nyarurato/RRFExtRP2040Board/docs/v0.2/RRFExtRP2040_v_0_2.pdf

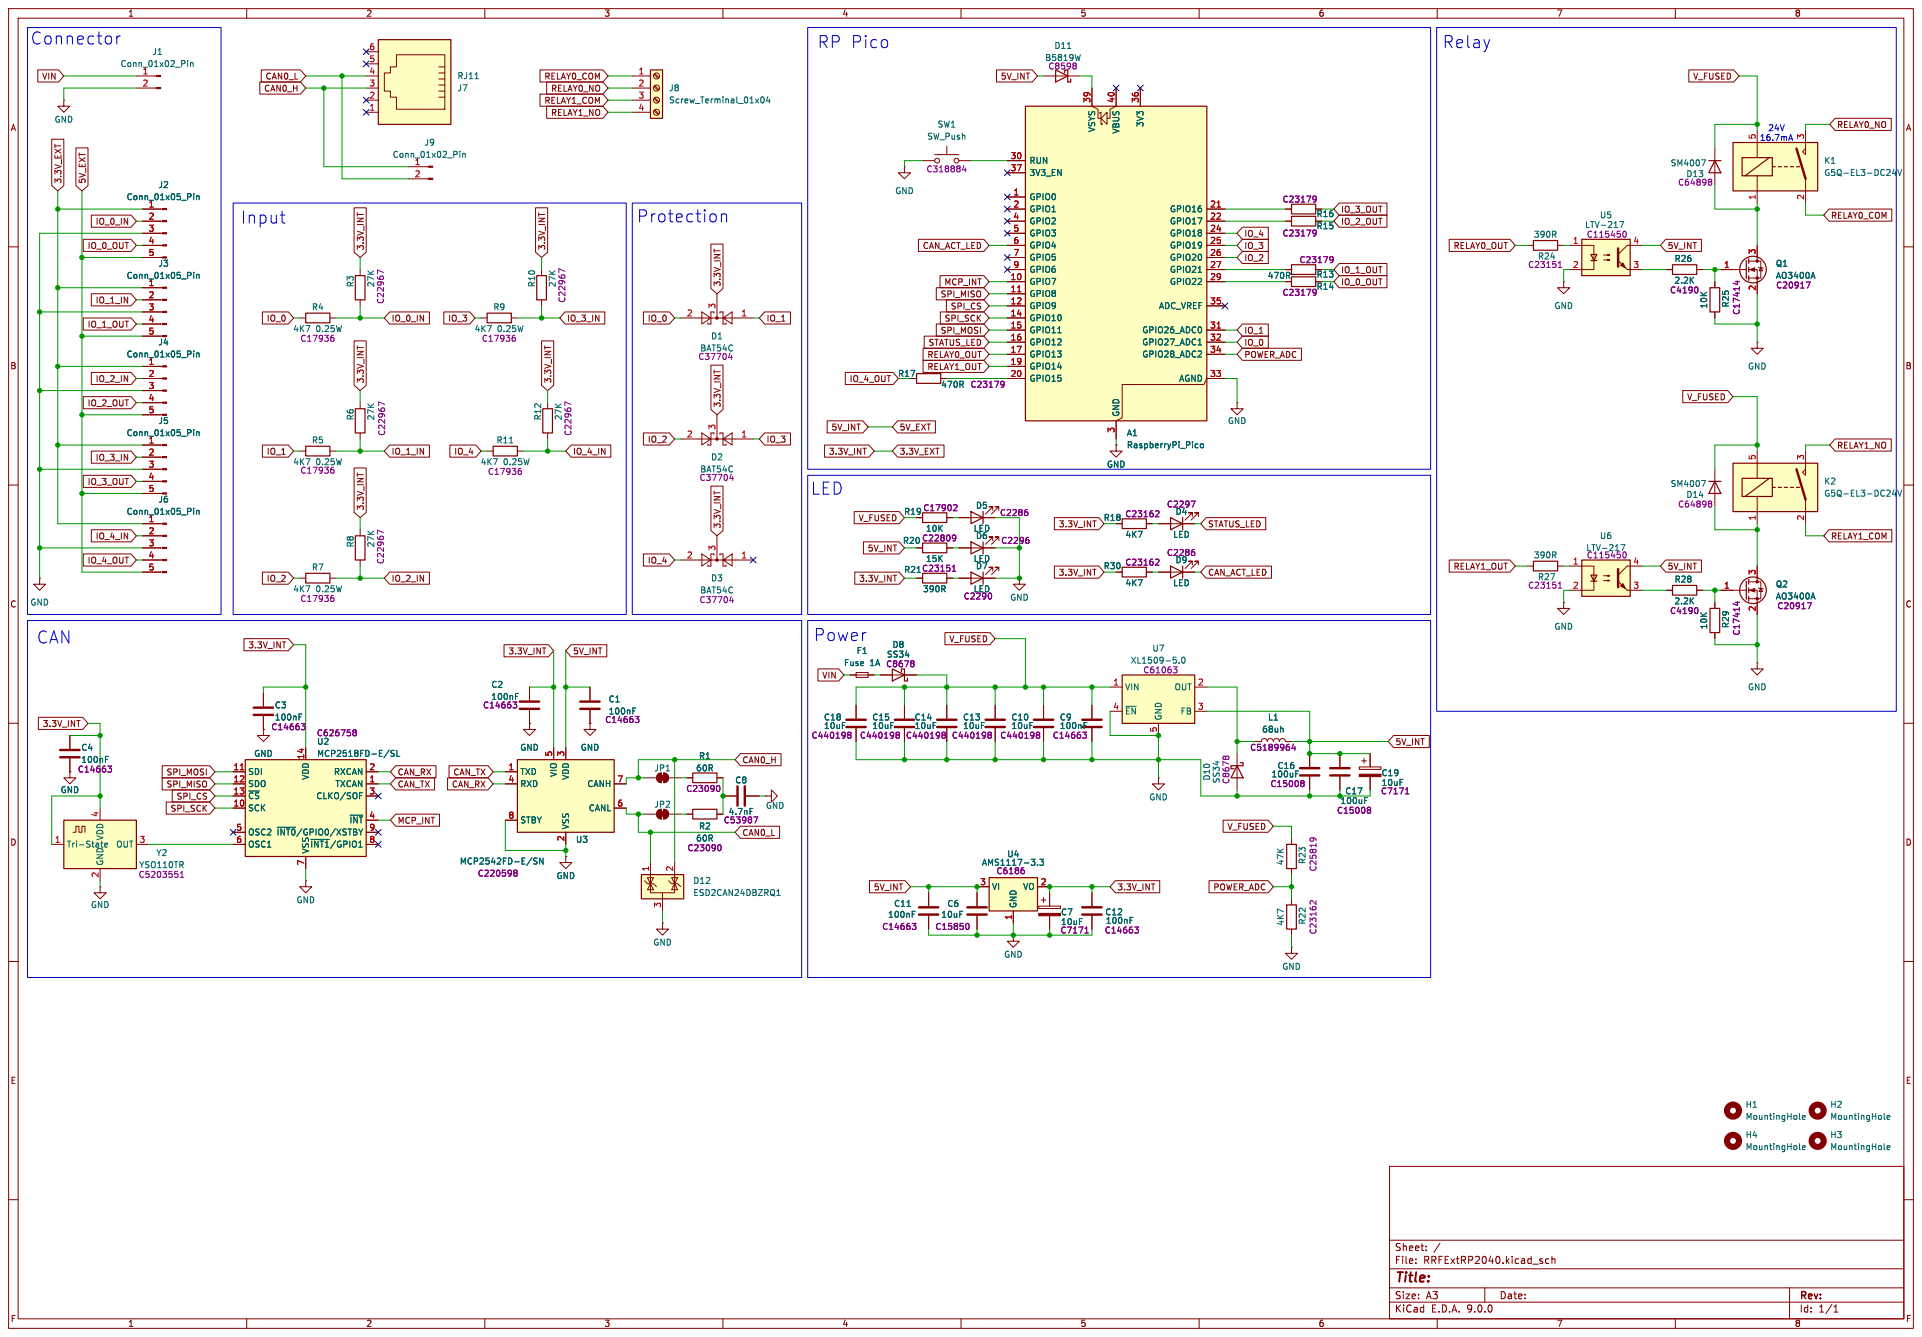
[picture p5: page 1]

7 RXCAN 2 TXCAN 1 CLKO/SOF 3 ~{INT}4 ~{INT0}/GPIO0/XSTBY 9 ~{INT1}/GPIO1 8 U2 MCP2518FD-E/SL C626758 GND

7 RXCAN 2 TXCAN 1 CLKO/SOF 3 ~{INT}4 ~{INT0}/GPIO0/XSTBY 9 ~{INT1}/GPIO1 8 GND
