nyarurato/RRFExtRP2040Board/RRFExtRP2040.kicad_pcb

## KiCad design RRFExtRP2040.kicad_pcb (2026-07-21)

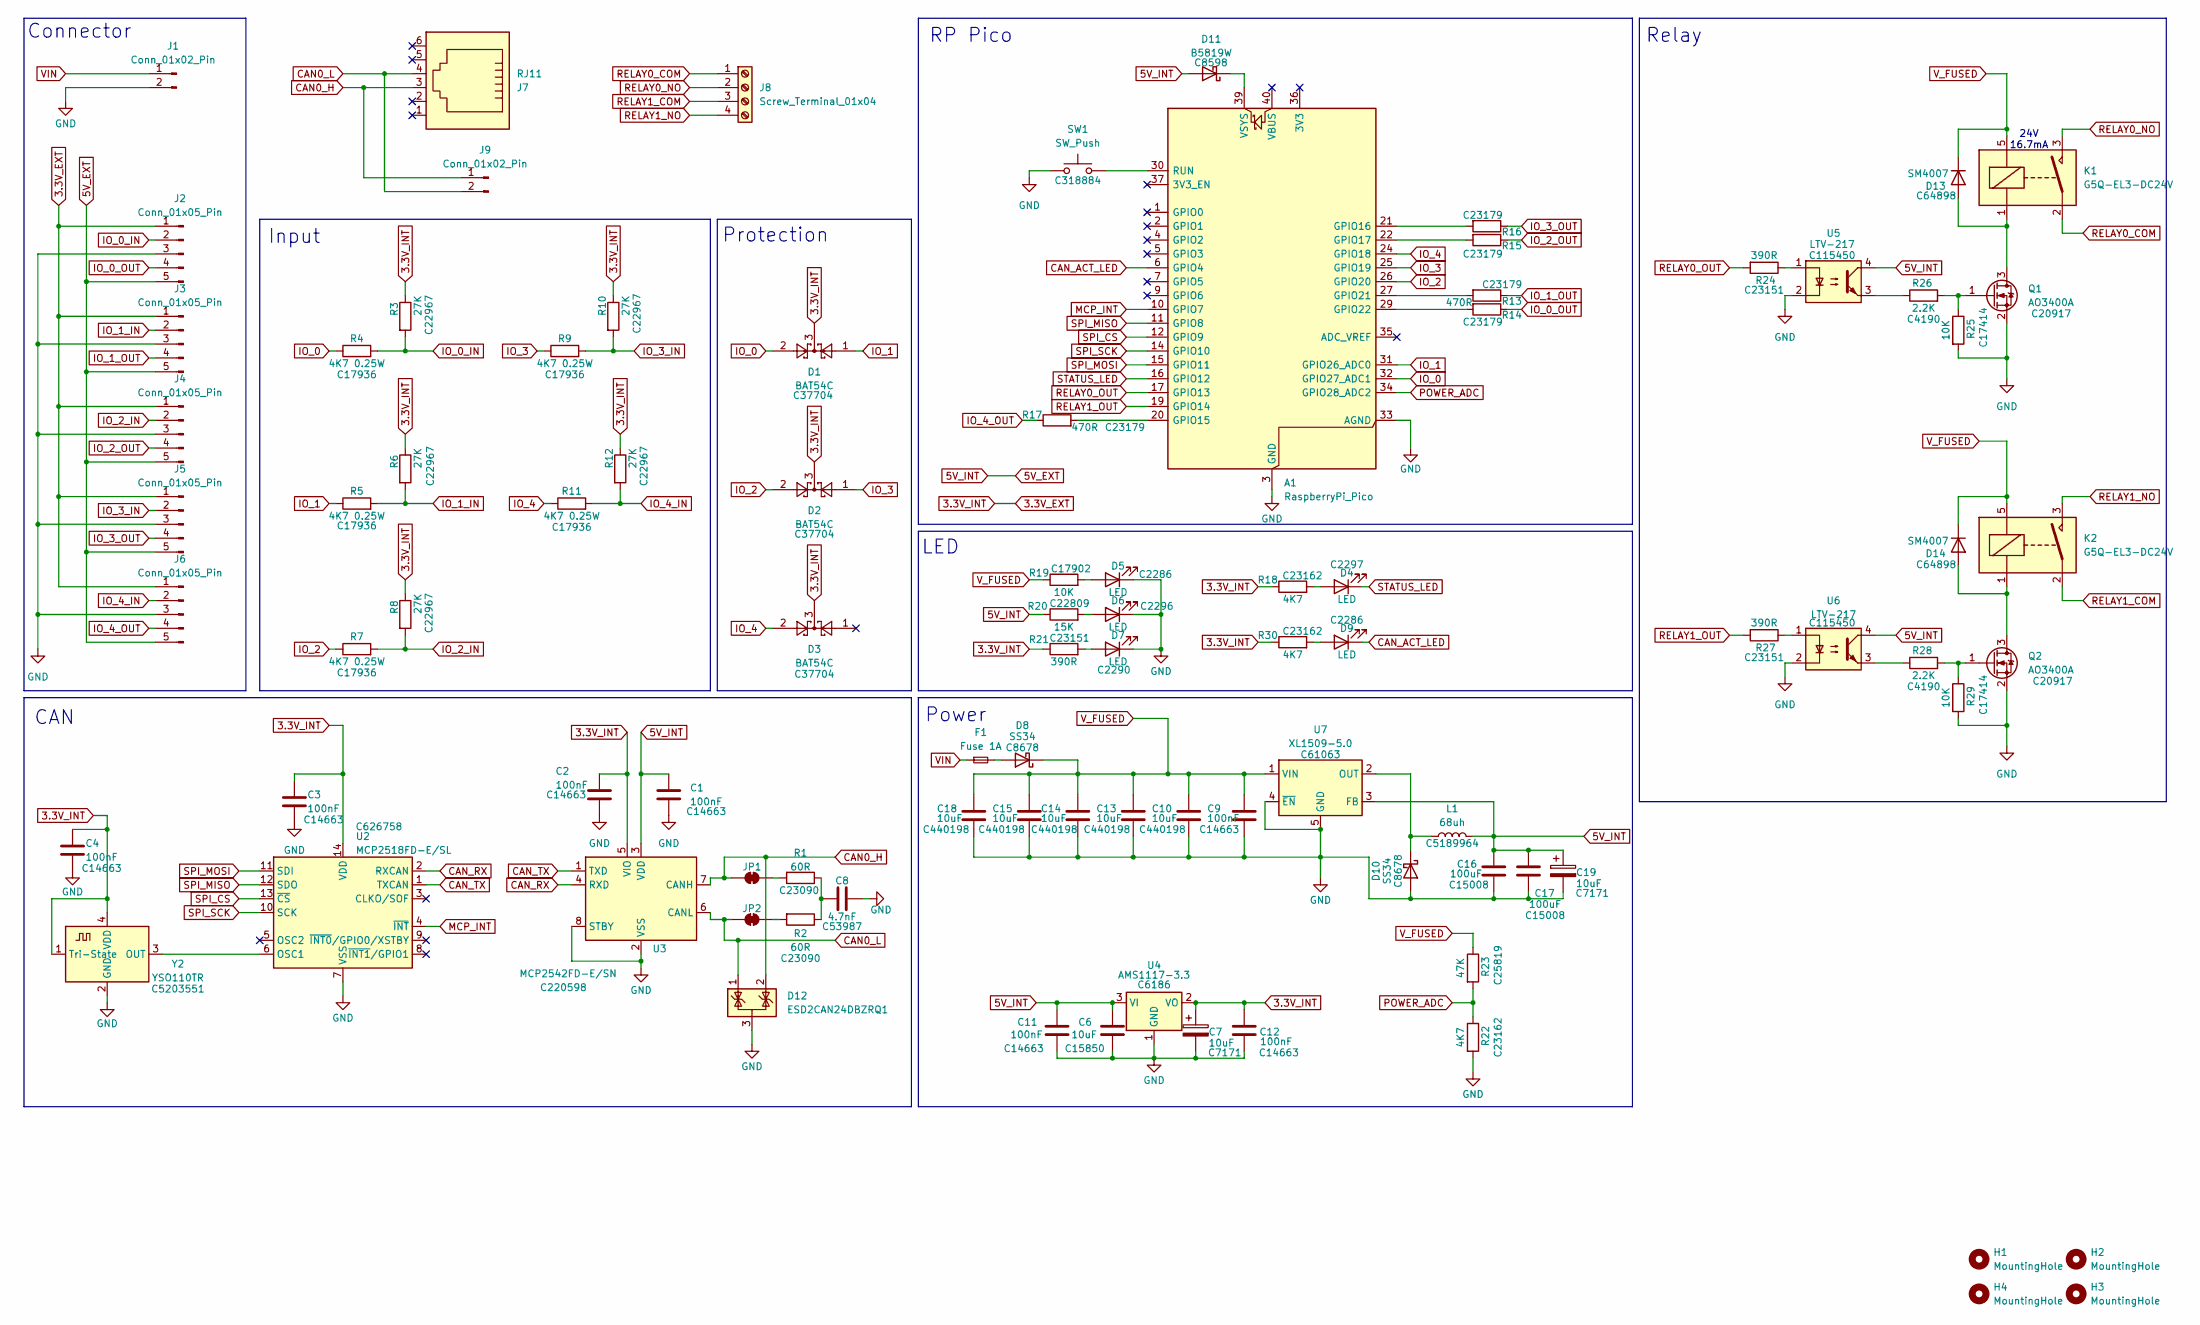
[picture p6: schematic RRFExtRP2040.kicad_sch]

Parts:
A1: RaspberryPi_Pico; RaspberryPi_Pico_Common_Unspecified
C1, C2, C3, C4, C9, C11, C12: 100nF; C_0603_1608Metric; LCSC PN C14663
C6: 10uF; C_0805_2012Metric; LCSC PN C15850
C7, C19: 10uF; CP_EIA-3216-18_Kemet-A; LCSC PN C7171
C8: 4.7nF; C_0603_1608Metric; LCSC PN C53987
C10, C13, C14, C15, C18: 10uF; C_0805_2012Metric; LCSC PN C440198
C16, C17: 100uF; C_1206_3216Metric; LCSC PN C15008
D1, D2, D3: BAT54C; SOT-23; LCSC PN C37704
D4: LED; LED_0805_2012Metric; LCSC PN C2297
D5, D9: LED; LED_0603_1608Metric; LCSC PN C2286
D6: LED; LED_0805_2012Metric; LCSC PN C2296
D7: LED; LED_0603_1608Metric; LCSC PN C2290
D8, D10: SS34; D_SMA; LCSC PN C8678
D11: B5819W; D_SOD-123; LCSC PN C8598
D12: ESD2CAN24DBZRQ1; SOT-23-3
D13, D14: SM4007; D_SOD-123F; LCSC PN C64898
F1: Fuse 1A; Fuse_1206_3216Metric
H1, H2, H3, H4: MountingHole; MountingHole_3.2mm_M3
J1: Conn_01x02_Pin; JST_VH_B2P-VH-B_1x02_P3.96mm_Vertical
J2, J3, J4, J5, J6: Conn_01x05_Pin; Molex_KK-254_AE-6410-05A_1x05_P2.54mm_Vertical
J7: RJ11; 615006138421
J8: Screw_Terminal_01x04; HB9500-9.5-4P
J9: Conn_01x02_Pin; Molex_KK-254_AE-6410-02A_1x02_P2.54mm_Vertical
JP1, JP2: SolderJumper_2_Bridged; SolderJumper-2_P1.3mm_Bridged_Pad1.0x1.5mm
K1, K2: G5Q-EL3-DC24V; Relay_SPST_Omron-G5Q-1A
L1: 68uh; IND-SMD_L7.2-W6.6_GPSR07X0; LCSC PN C5189964
Q1, Q2: AO3400A; SOT-23; LCSC PN C20917
R1, R2: 60R; R_0603_1608Metric; LCSC PN C23090
R3, R6, R8, R10, R12: 27K; R_0603_1608Metric; LCSC PN C22967
R4, R5, R7, R9, R11: 4K7 0.25W; R_1206_3216Metric; LCSC PN C17936
R13, R14, R15, R16, R17: 470R; R_0603_1608Metric; LCSC PN C23179
R18, R22, R30: 4K7; R_0603_1608Metric; LCSC PN C23162
R19: 10K; R_1206_3216Metric; LCSC PN C17902
R20: 15K; R_0603_1608Metric; LCSC PN C22809
R21, R24, R27: 390R; R_0603_1608Metric; LCSC PN C23151
R23: 47K; R_0603_1608Metric; LCSC PN C25819
R25, R29: 10K; R_0805_2012Metric; LCSC PN C17414
R26, R28: 2.2K; R_0603_1608Metric; LCSC PN C4190
SW1: SW_Push; SW_Push_1P1T_XKB_TS-1187A; LCSC PN C318884
U2: MCP2518FD-E/SL; SOIC-14_3.9x8.7mm_P1.27mm; LCSC PN C626758
U3: MCP2542FD-E/SN; SOIC-8_3.9x4.9mm_P1.27mm; LCSC PN C220598
U4: AMS1117-3.3; SOT-223-3_TabPin2; LCSC PN C6186
U5, U6: LTV-217; LTV217; LCSC PN C115450
U7: XL1509-5.0; SOIC-8_3.9x4.9mm_P1.27mm; LCSC PN C61063
Y2: YSO110TR; Crystal_SMD_3225-4Pin_3.2x2.5mm; LCSC PN C5203551

Connections:
3.3V_EXT: C2.1, C3.1, C4.1, C7.1, C12.2, D1.3, D2.3, D3.3, J2.1, J3.1, J4.1, J5.1, J6.1, R3.1, R6.1, R8.1, R10.1, R12.1, R18.1, R21.1, R30.1, U2.14 (VDD), U3.5 (VIO), U4.2 (VO), Y2.1 (Tri-State), Y2.4 (VDD)
5V_EXT: C1.1, C6.1, C11.1, C16.1, C17.1, C19.1, D11.2 (A), J2.5, J3.5, J4.5, J5.5, J6.5, L1.2, R20.1, U3.3 (VDD), U4.3 (VI), U5.4, U6.4, U7.3 (FB)
CAN0_H: D12.2 (K), J7.3, J9.1, JP1.1 (A), U3.7 (CANH)
CAN0_L: D12.1 (K), J7.4, J9.2, JP2.1 (A), U3.6 (CANL)
CAN_ACT_LED: A1.6 (GPIO4), D9.1 (K)
CAN_RX: U2.2 (RXCAN), U3.4 (RXD)
CAN_TX: U2.1 (TXCAN), U3.1 (TXD)
GND: A1.3 (GND), A1.8 (GND), A1.13 (GND), A1.18 (GND), A1.23 (GND), A1.28 (GND), A1.33 (AGND), A1.38 (GND), C1.2, C2.2, C3.2, C4.2, C6.2, C7.2, C8.2, C9.2, C10.2, C11.2, C12.1, C13.2, C14.2, C15.2, C16.2, C17.2, C18.2, C19.2, D5.1 (K), D6.1 (K), D7.1 (K), D10.2 (A), D12.3 (A), J1.2, J2.3, J3.3, J4.3, J5.3, J6.3, Q1.2 (S), Q2.2 (S), R22.2, R25.2, R29.2, SW1.1, U2.7 (VSS), U3.2 (VSS), U3.8 (STBY), U3.9 (VSS), U4.1 (GND), U5.2, U6.2, U7.4 (~EN), U7.5 (GND), U7.6 (GND), U7.7 (GND), U7.8 (GND), Y2.2 (GND)
IO_0: A1.32 (GPIO27_ADC1), D1.2, R4.1
IO_0_IN: J2.2, R3.2, R4.2
IO_0_OUT: J2.4, R14.1
IO_1: A1.31 (GPIO26_ADC0), D1.1, R5.1
IO_1_IN: J3.2, R5.2, R6.2
IO_1_OUT: J3.4, R13.1
IO_2: A1.26 (GPIO20), D2.2, R7.1
IO_2_IN: J4.2, R7.2, R8.2
IO_2_OUT: J4.4, R15.1
IO_3: A1.25 (GPIO19), D2.1, R9.1
IO_3_IN: J5.2, R9.2, R10.2
IO_3_OUT: J5.4, R16.1
IO_4: A1.24 (GPIO18), D3.2, R11.1
IO_4_IN: J6.2, R11.2, R12.2
IO_4_OUT: J6.4, R17.1
MCP_INT: A1.10 (GPIO7), U2.4 (~INT)
unnamed: A1.20 (GPIO15), R17.2
unnamed: A1.21 (GPIO16), R16.2
unnamed: A1.22 (GPIO17), R15.2
unnamed: A1.27 (GPIO21), R13.2
unnamed: A1.29 (GPIO22), R14.2
unnamed: A1.30 (RUN), SW1.2
unnamed: A1.39 (VSYS), D11.1 (K)
unnamed: C8.1, R1.1, R2.1
unnamed: D4.2 (A), R18.2
unnamed: D5.2 (A), R19.2
unnamed: D6.2 (A), R20.2
unnamed: D7.2 (A), R21.2
unnamed: D8.2 (A), F1.2
unnamed: D9.2 (A), R30.2
unnamed: D10.1 (K), L1.1, U7.2 (OUT)
unnamed: D13.2 (A), K1.1, Q1.3 (D)
unnamed: D14.2 (A), K2.1, Q2.3 (D)
unnamed: JP1.2 (B), R1.2
unnamed: JP2.2 (B), R2.2
unnamed: Q1.1 (G), R25.1, R26.2
unnamed: Q2.1 (G), R28.2, R29.1
unnamed: R24.1, U5.1
unnamed: R26.1, U5.3
unnamed: R27.1, U6.1
unnamed: R28.1, U6.3
unnamed: U2.6 (OSC1), Y2.3 (OUT)
POWER_ADC: A1.34 (GPIO28_ADC2), R22.1, R23.2
RELAY0_COM: J8.1, K1.2
RELAY0_NO: J8.2, K1.3
RELAY0_OUT: A1.17 (GPIO13), R24.2
RELAY1_COM: J8.3, K2.2
RELAY1_NO: J8.4, K2.3
RELAY1_OUT: A1.19 (GPIO14), R27.2
SPI_CS: A1.12 (GPIO9), U2.13 (~CS)
SPI_MISO: A1.11 (GPIO8), U2.12 (SDO)
SPI_MOSI: A1.15 (GPIO11), U2.11 (SDI)
SPI_SCK: A1.14 (GPIO10), U2.10 (SCK)
STATUS_LED: A1.16 (GPIO12), D4.1 (K)
VIN: F1.1, J1.1
V_FUSED: C9.1, C10.1, C13.1, C14.1, C15.1, C18.1, D8.1 (K), D13.1 (K), D14.1 (K), K1.5, K2.5, R19.1, R23.1, U7.1 (VIN)

Notes on the sheet:
CAN
RP Pico
24V 16.7mA
Connector
Protection
Relay
LED
Power
Input

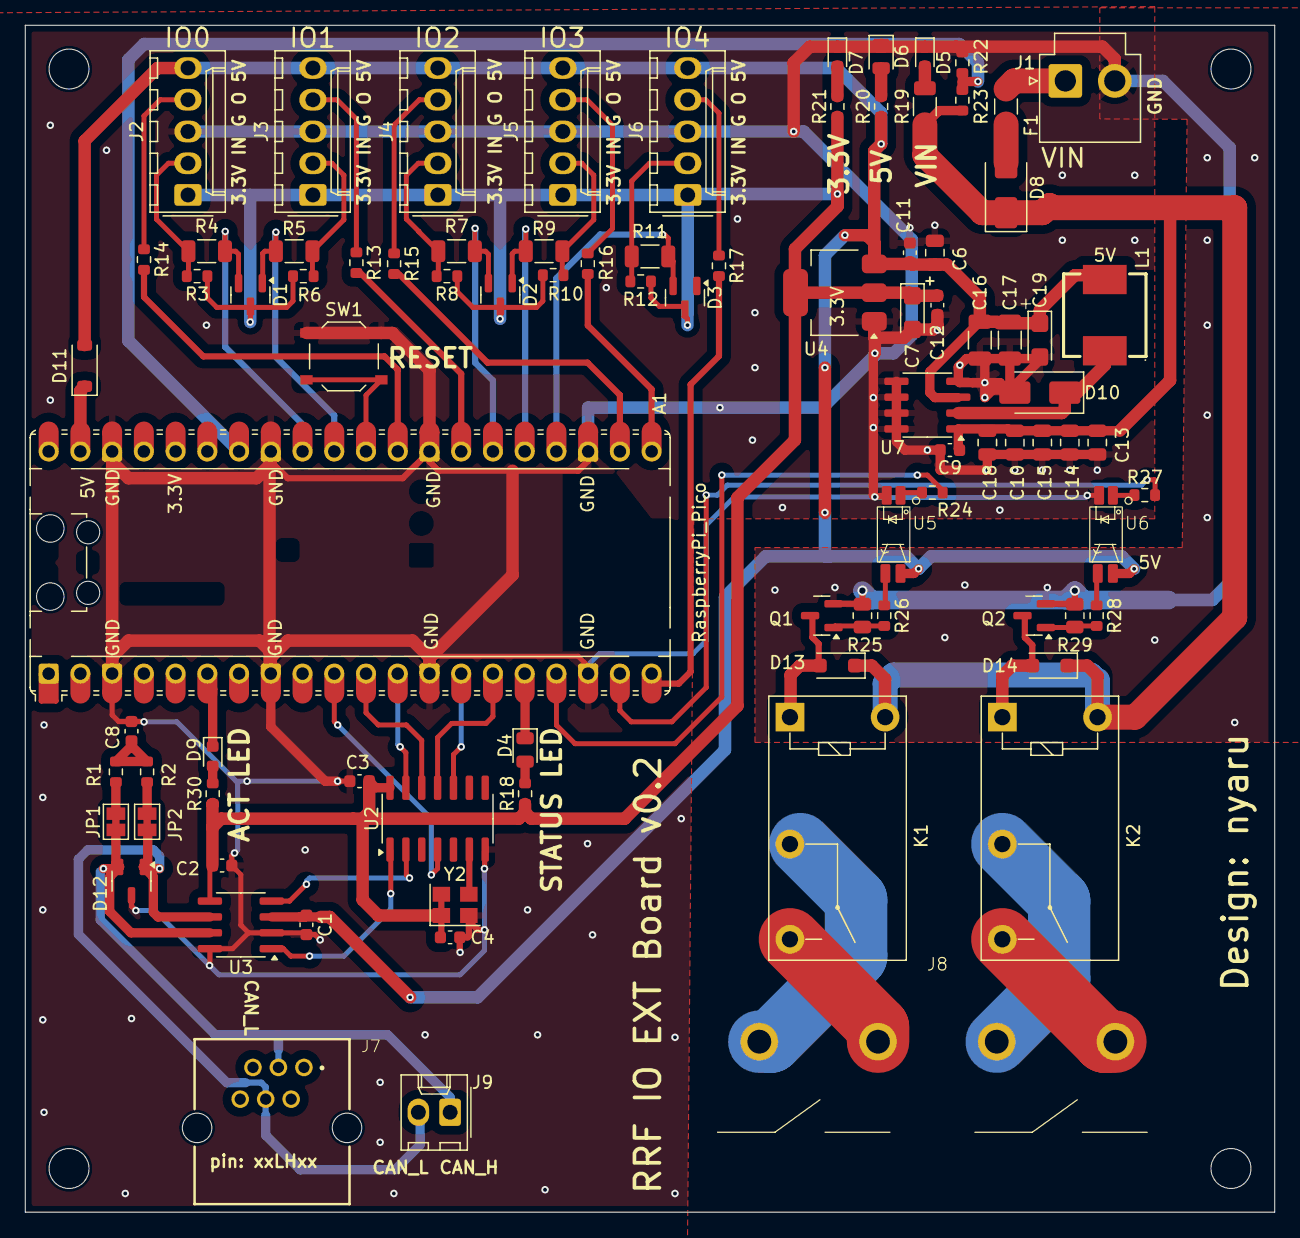
[picture p7: board RRFExtRP2040.kicad_pcb from above]

Board: 2 copper layers, 100.0 x 95.0 mm, 92 parts (0 on the bottom side), 64 nets.
